MAXRUNER/Tennis-Vibration-Monitoring/(commit log)

2026-08-23 Minor fixes
    Fix missing declaration armed variable declaration
    Refactor state management in nextSession and processHit functions to reset state variables more clearly
    [tennis_vibrational_monitoring.ino]
2026-08-23 Change TRIGGER pin from 8 to 4
    Increased sensitivity
2026-08-23 Add CSV Reader Utility
    Reading the CSV file stored in flash memory is not straightforward, so this commit adds a utility for exporting the data without modifying its contents
    Collect the data first, then upload the CSV reader sketch to the device. Finally, open the Serial Monitor (115200 baud) to view and copy the recorded measurements
2026-09-02 Replace magic number
    If it's good enough for Java, it's good enough for my racket
    [tennis_vibrational_monitoring.ino]
2026-09-28 Schematic revision
    Initial Upload of the schematic
    [Tennis_Logitudinal_monitoring.kicad_sch]
2026-09-28 Add Schematic image for reference
    Added Schematic image
2026-10-03 PCB Files Upload
2026-10-03 PCB Files re-upload
    [Tennis_Logitudinal_monitoring-B_Cu.gbr, Tennis_Logitudinal_monitoring-B_Mask.gbr, Tennis_Logitudinal_monitoring-B_Paste.gbr, Tennis_Logitudinal_monitoring-B_Silkscreen.gbr, Tennis_Logitudinal_monitoring-Edge_Cuts.gbr, Tennis_Logitudinal_monitoring-F_Cu.gbr, Tennis_Logitudinal_monitoring-F_Mask.gbr, Tennis_Logitudinal_monitoring-F_Paste.gbr]
2026-10-03 Enhance README with PCB details and mishit detection
    Added details about the ordered PCB specifications and mishit detection cases. Updated the build instructions to specify the firmware file name.
2026-10-28 Update hit processing to match paper
    Added logic to track previous impacts and mishits in the state structure.
2026-10-29 Document 12 second timer feature in README
    Added information about a 12 second timer feature for recording shots.
